tirfil/digital_billboard/photos/rpi.png

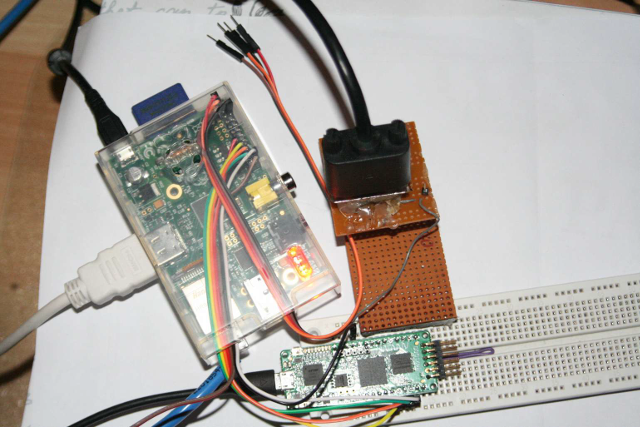
photos/rpi.png
