tirfil/digital_billboard/photos/IMG_2739.PNG

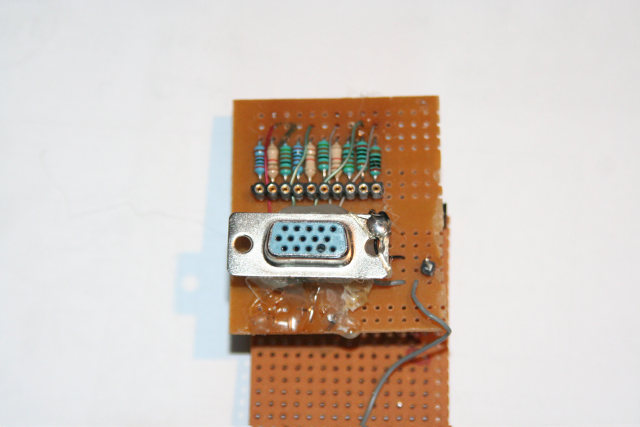
photos/IMG_2739.PNG
