tirfil/digital_billboard/photos/IMG_2740.PNG

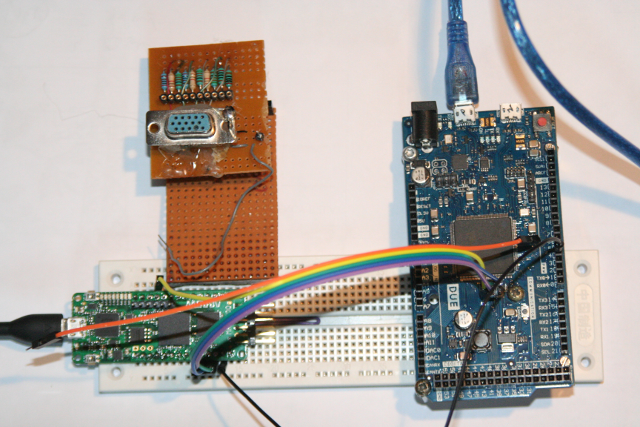
photos/IMG_2740.PNG
