tirfil/digital_billboard/PYTHON/arrow.gif

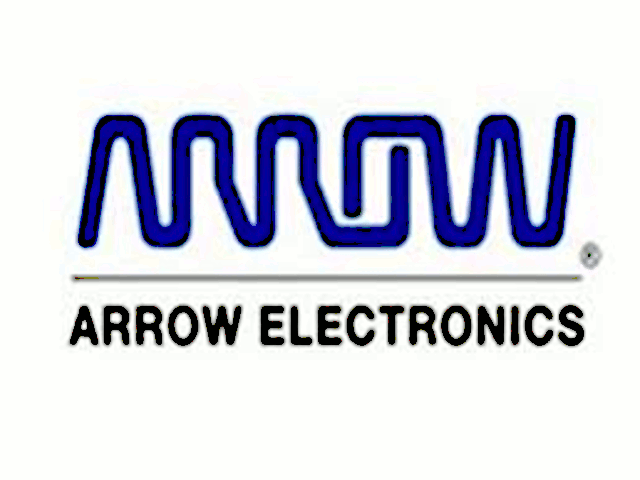
PYTHON/arrow.gif
